g0rd0n2007/frsky-tb/(commit log)

2025-09-08 A3 and Current (and Capacity) improvement and test
2025-09-08 Board real image
2025-09-13 Adjustment of Current factor for HW 200A
